ddtdanilo/Proyectos-III-War-of-Tanks/Camera/data/background.jpg

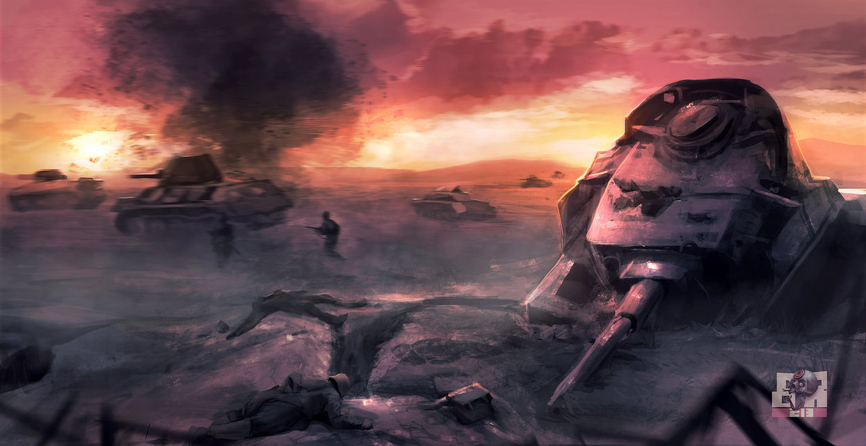
Camera/data/background.jpg
