ddtdanilo/Proyectos-III-War-of-Tanks/README.md

# Proyectos-III-War-of-Tanks

La batalla de Kursk (Operación Ciudadela) fue uno de los combates más grandes de la historia, ocurrido entre Julio y Agosto de 1943 durante la Segunda Guerra Mundial . En ella hubo un gran despliegue de tanques de combate (alrededor de 13.000) por parte de Rusia y Alemania. El proyecto es simular este enfrentamiento utilizando dos robots tipo tanque autónomos, que se detecten el uno al otro y que activen un led cuando se encuentren.

Para llevar a cabo este simulacro es necesario utilizar diversos tipos de sensores como infrarrojos, ultrasonido y una cámara USB. Además, se controla el movimiento de los motores utilizando un puente H, en conjunto con dos encoders y se establece comunicación entre la interfaz gráfica y el tanque utilizando un emisor/receptor infrarrojo y un arduino.

A continuación se muestra cómo se realizó la adquisición y emisión de datos y la interfaz gráfica, en conjunto con la implementación de cada uno de los sensores utilizados.
