ddtdanilo/Proyectos-III-War-of-Tanks/(list of files, cad)

Other CAD files:
MCU_PIII/FLASH/Sources/main_c.obj
Camera/MCU_PIII/FLASH/Sources/main_c.obj
Primera_Fase/MCU_PIII/FLASH/Sources/main_c.obj
Camera/MCU_PIII/FLASH/Generated_Code/Encoder_2_t_c.obj
Camera/MCU_PIII/FLASH/Project_Settings/Startup_Code/start08_c.obj
Camera/MCU_PIII/FLASH/Sources/Tanque_c.obj
MCU_PIII/FLASH/Generated_Code/Serial_1_c.obj
Primera_Fase/MCU_PIII/FLASH/Sources/Tanque_c.obj
Camera/MCU_PIII/FLASH/Generated_Code/M_1_c.obj
MCU_PIII/FLASH/Generated_Code/Serial_2_c.obj
MCU_PIII/FLASH/Sources/Tanque_c.obj
Camera/MCU_PIII/FLASH/Generated_Code/DISPARO_OUT_c.obj
Camera/MCU_PIII/FLASH/Sources/Events_c.obj
MCU_PIII/FLASH/Generated_Code/Enconder_Int_2_c.obj
MCU_PIII/FLASH/Sources/Events_c.obj
Primera_Fase/MCU_PIII/FLASH/Sources/Events_c.obj
Camera/MCU_PIII/FLASH/Generated_Code/TI1_c.obj
MCU_PIII/FLASH/Generated_Code/US_c.obj
Camera/MCU_PIII/FLASH/Generated_Code/Cpu_c.obj
MCU_PIII/FLASH/Generated_Code/ADC_c.obj
Camera/MCU_PIII/FLASH/Generated_Code/M2_P_c.obj
MCU_PIII/FLASH/Generated_Code/TI1_c.obj
Camera/MCU_PIII/FLASH/Generated_Code/LED_1_c.obj
MCU_PIII/FLASH/Generated_Code/Enconder_Int_1_c.obj
Camera/MCU_PIII/FLASH/Generated_Code/B_1_c.obj
MCU_PIII/FLASH/Generated_Code/M_1_c.obj
Camera/MCU_PIII/FLASH/Generated_Code/LED_OUT_1K_SQ_c.obj
MCU_PIII/FLASH/Generated_Code/B_1_c.obj
Camera/MCU_PIII/FLASH/Generated_Code/Serial_1_c.obj
MCU_PIII/FLASH/Generated_Code/Cpu_c.obj
Primera_Fase/MCU_PIII/FLASH/Generated_Code/LED_OUT_c.obj
Camera/MCU_PIII/FLASH/Generated_Code/ULTRA_c.obj
MCU_PIII/FLASH/Generated_Code/Vectors_c.obj
Camera/MCU_PIII/FLASH/Generated_Code/Vectors_c.obj
Camera/MCU_PIII/FLASH/Generated_Code/Encoder_1_t_c.obj
Camera/MCU_PIII/FLASH/Generated_Code/US_c.obj
Camera/MCU_PIII/FLASH/Generated_Code/Bit1_c.obj
Camera/MCU_PIII/FLASH/Generated_Code/PE_Timer_c.obj
Camera/MCU_PIII/FLASH/Generated_Code/Serial_2_c.obj
Camera/MCU_PIII/FLASH/Generated_Code/M1_P_c.obj
Camera/MCU_PIII/FLASH/Generated_Code/ACKNOWLEDGE_LED_c.obj
Camera/MCU_PIII/FLASH/Generated_Code/Enconder_Int_2_c.obj
Camera/MCU_PIII/FLASH/Generated_Code/Enconder_Int_1_c.obj
Camera/MCU_PIII/FLASH/Generated_Code/PPG1_c.obj
Camera/MCU_PIII/FLASH/Generated_Code/M_2_c.obj
Camera/MCU_PIII/FLASH/Generated_Code/ADC_c.obj
Camera/MCU_PIII/FLASH/Generated_Code/IO_Map_c.obj
Primera_Fase/MCU_PIII/FLASH/Generated_Code/ADC_c.obj
Primera_Fase/MCU_PIII/FLASH/Generated_Code/B_1_c.obj
Primera_Fase/MCU_PIII/FLASH/Generated_Code/Cpu_c.obj
Primera_Fase/MCU_PIII/FLASH/Generated_Code/IO_Map_c.obj
Primera_Fase/MCU_PIII/FLASH/Generated_Code/LED_1_c.obj
Primera_Fase/MCU_PIII/FLASH/Generated_Code/M_1_c.obj
Primera_Fase/MCU_PIII/FLASH/Generated_Code/M_2_c.obj
Primera_Fase/MCU_PIII/FLASH/Generated_Code/PE_Timer_c.obj
Primera_Fase/MCU_PIII/FLASH/Generated_Code/Serial_1_c.obj
Primera_Fase/MCU_PIII/FLASH/Generated_Code/Serial_2_c.obj
Primera_Fase/MCU_PIII/FLASH/Generated_Code/Vectors_c.obj
Primera_Fase/MCU_PIII/FLASH/Project_Settings/Startup_Code/start08_c.obj
