ddtdanilo/Proyectos-III-War-of-Tanks/(commit log)

2014-11-23 Todo inicializado y funcional
    [ACKNOWLEDGE_LED_c.obj, ADC_c.obj, B_1_c.obj, Bit1_c.obj, Cpu_c.obj, DISPARO_OUT_c.obj, Encoder_1_t_c.obj, Encoder_2_t_c.obj]
2014-11-26 Algoritmo de búsqueda parametrizado, y ultrasonido.
    [ACKNOWLEDGE_LED_c.obj, ADC_c.obj, B_1_c.obj, Bit1_c.obj, Cpu_c.obj, DISPARO_OUT_c.obj, Encoder_1_t_c.obj, Encoder_2_t_c.obj]
2014-11-26 Interfaz gráfica de comunicacion. JUEGO
    Sin implementar el puerto serial.
2014-11-26 Envio Serial activado.
    1200 Baudios. Control para mantener en cancha.
2014-11-26 Funcional con ultrasonido -> 4 seguro
    [ACKNOWLEDGE_LED_c.obj, ADC_c.obj, B_1_c.obj, Bit1_c.obj, Cpu_c.obj, DISPARO_OUT_c.obj, Encoder_1_t_c.obj, Encoder_2_t_c.obj]
2014-11-26 Funcionando con ultrasonido, y puerto serial TV+ fi
    Funcionando con ultrasonido, y puerto serial TV+ filtro :dancer:
    [ACKNOWLEDGE_LED_c.obj, ADC_c.obj, B_1_c.obj, Bit1_c.obj, Cpu_c.obj, DISPARO_OUT_c.obj, Encoder_1_t_c.obj, Encoder_2_t_c.obj]
